AnasSarkiz/BlinkBuddy/(commit log)

2026-05-21 add cad
    [blinkbuddy_case.scad]
2026-05-22 update Cad
    [blinkbuddy_case.scad]
2026-05-22 eplaced the weak 200 mA regulator with XC6220B331MR-G
2026-05-24 Fix short GND/3V3
2026-06-29 Added QR code for the board project
2026-06-29 Fixed the ESP32-C3 decoupling placement by moving C1 from the middle of the board to just above U1, outside the antenna keepout:
2026-06-29 fixed the remaining real electrical issues
    [main.cpp, main.py]
2026-06-30 fix the QR USING silkscreen graph
